camilaqPereira/se-planta-industrial/(commit log)

2025-05-31 Load i2c img
2025-05-31 Upload schematic img
2025-05-31 Fix spelling in documentation
    [se_automacao_industrial_supervisor.ino]
